harshith998/ORCA-Optical-Replication-Control-Apparatus/software/chamber-pi/src/io_controller.py

import RPi.GPIO as GPIO
from rpi_hardware_pwm import HardwarePWM

from config import (
    SWITCH1_PIN, SWITCH2_PIN, SWITCH3_PIN, PWM_PIN,
    LORA_SPI_PORT, LORA_SPI_DEVICE, LORA_NRESET_PIN, LORA_BUSY_PIN, LORA_DIO1_PIN,
    LORA_FREQ_MHZ, LORA_BW_KHZ, LORA_SF, LORA_CR, LORA_SYNC_WORD,
    PWM_FREQ, MAX_PWM_VALUE,
    LED_GRN_PIN, LED_YLW_PIN,
    ROTARY_A_PIN, ROTARY_B_PIN, ROTARY_BTN_PIN,
)
from lora_receiver import LoRaReceiver, decode_packet, PACKET_SIZE
from rotary_encoder import RotaryEncoder
from rs_receiver import RS485Receiver


class IOController:
    def __init__(self):
        # State variables
        self.sw1 = True
        self.sw2 = True
        self.sw3 = True
        self.lux_value = 0

        # Hardware handles
        self.lora = None
        self._pwm = None  # rpi-hardware-pwm instance for BCM 12 (PWM0)
        self.rs = RS485Receiver()
        self.rotary = RotaryEncoder(ROTARY_A_PIN, ROTARY_B_PIN, ROTARY_BTN_PIN)

        # YLW LED flash counter: set to N on packet receipt, decremented each update
        self._ylw_flash_ticks = 0

        # Set to True when a new packet is decoded; cleared by consume_new_packet()
        self._new_packet = False

        # Last decoded LoRa packet (full spectral + GPS data)
        self.last_packet = None

        # All 13 spectral channels from the last packet (keyed by channel name)
        self.spectral_channels = {}

        # Last GPS fix from the last packet
        self.last_gps = {'valid': False, 'latitude': 0.0, 'longitude': 0.0, 'unix_time': 0}

        # Init / diagnostics
        self.status = {
            'gpio': 'Not initialized',
            'pwm': 'Not initialized',
            'lora': 'Not initialized',
            'rs485': 'Not initialized',
            'leds': 'Not initialized',
            'rotary': 'Not initialized',
        }
        self.hardware_ready = {
            'gpio': False,
            'pwm': False,
            'lora': False,
        }

    def begin(self):
        """Initialize all hardware peripherals without crashing if optional hardware is absent."""
        # GPIO setup
        try:
            GPIO.setmode(GPIO.BCM)
            GPIO.setwarnings(False)
            GPIO.setup(SWITCH1_PIN, GPIO.IN, pull_up_down=GPIO.PUD_UP)
            GPIO.setup(SWITCH2_PIN, GPIO.IN, pull_up_down=GPIO.PUD_UP)
            GPIO.setup(SWITCH3_PIN, GPIO.IN, pull_up_down=GPIO.PUD_UP)
            self.status['gpio'] = (
                f"OK - GPIO ready (S1=BCM{SWITCH1_PIN}, S2=BCM{SWITCH2_PIN}, S3=BCM{SWITCH3_PIN}, PWM=BCM{PWM_PIN})"
            )
            self.hardware_ready['gpio'] = True
        except Exception as exc:
            self.status['gpio'] = f"Unavailable - GPIO init failed: {exc}"

        # Hardware PWM via Linux sysfs (rpi-hardware-pwm) — runs in the PWM peripheral,
        # independent of Python. Requires dtoverlay=pwm,pin=12,func=4 in config.txt.
        try:
            self._pwm = HardwarePWM(pwm_channel=0, hz=PWM_FREQ, chip=0)
            self._pwm.start(0)
            self.status['pwm'] = f"OK - hardware PWM on BCM{PWM_PIN} at {PWM_FREQ} Hz (sysfs)"
            self.hardware_ready['pwm'] = True
        except Exception as exc:
            self._pwm = None
            self.status['pwm'] = (
                f"Unavailable - hardware PWM init failed: {exc}. "
                f"Ensure dtoverlay=pwm,pin=12,func=4 is in config.txt and Pi has been rebooted."
            )

        # Indicator LED setup (GRN = wired connected, YLW = RS-485 activity)
        if self.hardware_ready['gpio']:
            try:
                GPIO.setup(LED_GRN_PIN, GPIO.OUT, initial=GPIO.LOW)
                GPIO.setup(LED_YLW_PIN, GPIO.OUT, initial=GPIO.LOW)
                self.status['leds'] = (
                    f'OK - GRN=BCM{LED_GRN_PIN} (wired link), YLW=BCM{LED_YLW_PIN} (RS-485 activity)'
                )
            except Exception as exc:
                self.status['leds'] = f'Unavailable - LED init failed: {exc}'
        else:
            self.status['leds'] = 'Skipped - GPIO not available'

        # Rotary encoder setup (interrupt-driven, requires GPIO ready)
        if self.hardware_ready['gpio']:
            self.rotary.begin()
            self.status['rotary'] = self.rotary.status
        else:
            self.status['rotary'] = 'Skipped - GPIO not available'

        # RS-485 / wired UART setup (SNS sense pin + /dev/serial0)
        self.rs.begin()
        self.status['rs485'] = self.rs.status

        # LoRa setup (SX1262 on spidev0.1 / CE1)
        try:
            self.lora = LoRaReceiver(
                spi_port=LORA_SPI_PORT,
                spi_device=LORA_SPI_DEVICE,
                reset_pin=LORA_NRESET_PIN,
                busy_pin=LORA_BUSY_PIN,
                dio1_pin=LORA_DIO1_PIN,
            )
            self.lora.begin(
                freq_mhz=LORA_FREQ_MHZ,
                bw_khz=LORA_BW_KHZ,
                sf=LORA_SF,
                cr=LORA_CR,
                sync_word=LORA_SYNC_WORD,
            )
            self.status['lora'] = (
                f"OK - SX1262 receiving at {LORA_FREQ_MHZ} MHz "
                f"BW{LORA_BW_KHZ} SF{LORA_SF} CR4/{LORA_CR} sync=0x{LORA_SYNC_WORD:02X}"
            )
            self.hardware_ready['lora'] = True
        except Exception as exc:
            self.lora = None
            self.status['lora'] = f"Unavailable - LoRa init failed: {exc}"

    def update(self):
        """Update all input states."""
        self._read_switches()

        # Prefer wired RS-485 when a cable is detected, mirroring the firmware
        # path: is_connected() → rs485_send, else → LoRa.
        wired = self.rs.is_connected()
        if wired:
            self._read_rs485()
        else:
            self._read_lora()

        self._update_leds()

    def _update_leds(self):
        """Drive indicator LEDs based on connection and activity state."""
        if not self.hardware_ready.get('gpio'):
            return
        try:
            # GRN: solid on when RJ45 cable is plugged in
            GPIO.output(LED_GRN_PIN, GPIO.HIGH if self.rs.is_connected() else GPIO.LOW)

            # YLW: flashes for ~500 ms after each RS-485 packet is received
            if self._ylw_flash_ticks > 0:
                self._ylw_flash_ticks -= 1
                GPIO.output(LED_YLW_PIN, GPIO.HIGH)
            else:
                GPIO.output(LED_YLW_PIN, GPIO.LOW)
        except Exception as exc:
            print(f'[LED] Output error: {exc}')

    def _read_switches(self):
        """Read switch states (pull-up: HIGH = released)."""
        if not self.hardware_ready['gpio']:
            self.sw1 = True
            self.sw2 = True
            return
        self.sw1 = GPIO.input(SWITCH1_PIN)
        self.sw2 = GPIO.input(SWITCH2_PIN)
        self.sw3 = GPIO.input(SWITCH3_PIN)

    def _read_lora(self):
        """Poll SX1262 for a received packet and decode it."""
        if not self.hardware_ready['lora'] or self.lora is None:
            return
        try:
            raw = self.lora.poll()
            if raw is None:
                return
            if raw == b'':
                print("[LoRa] CRC error — packet discarded")
                return
            print(f"[LoRa] Packet received: {len(raw)} bytes | hex: {raw.hex()}")
            packet = decode_packet(raw)
            if packet is None:
                print(f"[LoRa] Decode failed: got {len(raw)} bytes, expected {PACKET_SIZE}")
                return
            self.last_packet = packet
            self.spectral_channels = packet['channels']
            self.lux_value = packet['channels']['clear']
            self.last_gps = packet['gps']
            self._new_packet = True
            print(f"[LoRa] Decoded: sample={packet['sample_count']} clear={packet['channels']['clear']} gps_valid={packet['gps']['valid']}")
        except Exception as exc:
            print(f"[LoRa] Exception in _read_lora: {exc}")

    def _read_rs485(self):
        """Poll the RS-485 UART for a complete packet and decode it."""
        packet = self.rs.poll()
        if packet is None:
            return
        print(f'[RS485] Packet received: sample={packet["sample_count"]} '
              f'clear={packet["channels"]["clear"]} gps_valid={packet["gps"]["valid"]}')
        self.last_packet = packet
        self.spectral_channels = packet['channels']
        self.lux_value = packet['channels']['clear']
        self.last_gps = packet['gps']
        self._new_packet = True
        # Trigger YLW flash for ~500 ms (5 ticks at 100 ms loop rate)
        self._ylw_flash_ticks = 5

    def is_wired_connected(self) -> bool:
        """Return True when a cable is detected on the RJ45 sense pin."""
        return self.rs.is_connected()

    def set_pwm(self, value):
        """Set PWM duty cycle (0-1023 maps to 0-100%).

        Delegates to hardware PWM peripheral via sysfs — continues at this
        duty cycle even if the Python process hangs between calls.
        """
        if not self.hardware_ready['pwm'] or self._pwm is None:
            return
        duty = (value / MAX_PWM_VALUE) * 100.0
        duty = max(0.0, min(100.0, duty))
        self._pwm.change_duty_cycle(duty)

    def get_switch1(self):
        return self.sw1

    def get_switch2(self):
        return self.sw2

    def get_switch3(self):
        return self.sw3

    def get_lux_value(self):
        return self.lux_value

    def get_spectral_channels(self) -> dict:
        return dict(self.spectral_channels)

    def get_last_gps(self) -> dict:
        return dict(self.last_gps)

    def consume_new_packet(self) -> bool:
        """Returns True (and clears the flag) if a new packet was decoded this tick."""
        if self._new_packet:
            self._new_packet = False
            return True
        return False

    def get_rotary_position(self) -> int:
        return self.rotary.get_position()

    def consume_rotary_click(self) -> bool:
        return self.rotary.consume_click()

    def get_init_report(self):
        return dict(self.status)

    def to_string(self):
        """Return string representation for debugging."""
        sw1_str = "HIGH" if self.sw1 else "LOW "
        sw2_str = "HIGH" if self.sw2 else "LOW "
        return (f"[Switches] S1={sw1_str} S2={sw2_str} | "
                f"[Lux] {self.lux_value}")

    def cleanup(self):
        """Cleanup GPIO and peripherals."""
        if self._pwm is not None:
            try:
                self._pwm.stop()
            except Exception:
                pass
        if self.lora:
            try:
                self.lora.close()
            except Exception:
                pass
        try:
            self.rs.close()
        except Exception:
            pass
        try:
            self.rotary.cleanup()
        except Exception:
            pass
        try:
            GPIO.cleanup()
        except Exception:
            pass
