harshith998/ORCA-Optical-Replication-Control-Apparatus/firmware/module-esp32/src/main.cpp

#include <Wire.h>
#include "Adafruit_VEML7700.h"

// VEML7700 I2C Sensor Pins
#define SDA1 21
#define SCL1 22
#define SDA2 33
#define SCL2 32

// UART RS-485 Constants
#define SAMPLE_MS = 20
#define UART0_BAUD = 115200

// VEML7700 Setup
Adafruit_VEML7700 veml1 = Adafruit_VEML7700();
Adafruit_VEML7700 veml2 = Adafruit_VEML7700();
TwoWire I2C_1 = TwoWire(0);
TwoWire I2C_2 = TwoWire(1);
unsigned long lastSample = 0;

void setup() {
  Serial.begin(UART0_BAUD);
  
  // Initialize sensors
  I2C_1.begin(SDA1, SCL1);
  if (!veml1.begin(&I2C_1)) {
    Serial.println("ERROR: Failed to initialize VEML7700-1");
    ESP.restart(); // Attempt to restart ESP32
  }
  veml1.setGain(VEML7700_GAIN_1);
  veml1.setIntegrationTime(VEML7700_IT_100MS);
  
  I2C_2.begin(SDA2, SCL2);
  if (!veml2.begin(&I2C_2)) {
    Serial.println("ERROR: Failed to initialize VEML7700-2");
    ESP.restart(); // Attempt to restart ESP32
  }
  veml2.setGain(VEML7700_GAIN_1);
  veml2.setIntegrationTime(VEML7700_IT_100MS);
  
  delay(1000);  // Give receiver time to start
  lastSample = millis();
}

void loop() {
  // Transmit data every SAMPLE_MS milliseconds
  unsigned long now = millis();
  if (now - lastSample >= SAMPLE_MS) {
    lastSample = now;
    
    // Read both sensors and send averaged lux intensity via UART
    float lux1 = veml1.readLux();
    float lux2 = veml2.readLux();
    Serial.println((lux1 + lux2)/2.0, 2);
  }
}
