harshith998/ORCA-Optical-Replication-Control-Apparatus/firmware/chamber-esp32/test/test.cpp

#include <Arduino.h>
#include <Wire.h>

// ---------- Pin Definitions ----------
#define SWITCH1_PIN 14      // Input switch 1 with pull-up
#define SWITCH2_PIN 12       // Input switch 2 with pull-up
#define SWITCH3_PIN 27       // Potentiometer pin (measure voltage 3.3V)
#define PWM_PIN     25      // PWM output pin (GPIO25)
#define LCD_SDA     21      // LCD SDA Pin
#define LCD_SCL     22      // LCD SCL Pin
#define UART0_BAUD  115200  // UART0 baud rate

// ---------- PWM Settings ----------
#define PWM_FREQ     5000   // 5 kHz PWM
#define PWM_CHANNEL  0      // Default PWM Channel
#define PWM_RES_BITS 10     // 10-bit (0–1023)
#define MAX_PWM_VALUE 1023  // Max value for 10-bit

void setup() {
  Serial.begin(UART0_BAUD);           // UART0 (GPIO3 RX, GPIO1 TX)
  pinMode(SWITCH1_PIN, INPUT_PULLUP); // Switch 1
  pinMode(SWITCH2_PIN, INPUT_PULLUP); // Switch 2
  pinMode(SWITCH3_PIN, INPUT);        // Potentiometer voltage measuring
  pinMode(PWM_PIN, OUTPUT);           // Output PWM signal for controlling LEDs
  Wire.begin(LCD_SDA, LCD_SCL);
  Wire.setClock(400000); // 400 kHz (use 100000 for standard mode if needed)

  // Configure PWM
  ledcSetup(PWM_CHANNEL, PWM_FREQ, PWM_RES_BITS);
  ledcAttachPin(PWM_PIN, PWM_CHANNEL);

  Serial.println("ESP32 PWM control ready");
}

void loop() {
  // -------- Read UART0 RX3 line --------
  if (Serial.available()) {
    String line = Serial.readStringUntil('\n');
    line.trim();

    // Example incoming line: "252953,79.03,165.43"
    // Split by commas
    int firstComma = line.indexOf(',');
    int secondComma = line.indexOf(',', firstComma + 1);

    if (firstComma != -1 && secondComma != -1) {
      String val1Str = line.substring(firstComma + 1, secondComma);
      String val2Str = line.substring(secondComma + 1);
      float val1 = val1Str.toFloat();
      float val2 = val2Str.toFloat();

      float avg = (val1 + val2) / 2.0;

      // Scale and cap
      float dutyValue = avg;               // scale directly (0–10 000 range)
      if (dutyValue > 3500) dutyValue = 3500;

      // Convert to PWM range
      int pwmOut = map((int)dutyValue, 0, 3500, 0, MAX_PWM_VALUE);

      // -------- Switch control --------
      if (digitalRead(SWITCH1_PIN) == HIGH) {
        ledcWrite(PWM_CHANNEL, pwmOut);
      } else {
        ledcWrite(PWM_CHANNEL, 0);  // Force output LOW
      }

      // Debug print
      Serial.print("Input avg: ");
      Serial.print(avg, 2);
      Serial.print("  -> PWM duty: ");
      Serial.println(pwmOut);
    }
  }
}
