harshith998/ORCA-Optical-Replication-Control-Apparatus/(commit log)

2025-10-31 Update from old repo
    has all information from deprecitated repository
    [EGR 101-B_Cu.gbr, EGR 101-B_Mask.gbr, EGR 101-B_Paste.gbr, EGR 101-B_Silkscreen.gbr, EGR 101-Edge_Cuts.gbr, EGR 101-F_Cu.gbr, EGR 101-F_Mask.gbr, EGR 101-F_Paste.gbr]
2025-10-31 update reciever
    update reciever py code for Serial over Ethernet capabilities,, and pure PWM based LED projection instead of digital output.
2025-10-31 test for SerialOverEthernet
    This was code for simple test with hardware (successful) to validate chips and wiring schematic to send data over ethernet as serial byte-stream data.
2025-10-31 update sensor module
    Update sensor module logic to accomodate for Serial over Ethernet byte-stream transmission
2025-11-04 Fixed ESP32 code. Transmits CSV UART every 500 ms over 115200
    [1LED.cpp, Ethernet_connection.cpp, I2C_Switching.cpp, LCD_test1.cpp, esp32module.cpp, main.cpp, recieve.py]
2025-11-04 Pico ADC code finished. Baud set 115200 over TX. Read analog pin 26
2025-11-05 updated changes for LCD and switches analog control
2025-11-12 refactor for easy switching B/W reciever
2025-11-13 Test ESP32 Chamber
2025-11-14 REORGANIZED EVERYTHING
    [EGR 101-B_Cu.gbr, EGR 101-B_Mask.gbr, EGR 101-B_Paste.gbr, EGR 101-B_Silkscreen.gbr, EGR 101-Edge_Cuts.gbr, EGR 101-F_Cu.gbr, EGR 101-F_Mask.gbr, EGR 101-F_Paste.gbr]
2026-01-31 Started Satellite board. Next steps: fix power switch between solar and RJ45 on MPPT
    [satellite-board.kicad_pcb, satellite-board.kicad_sch]
2026-01-31 wait more changes
    [satellite-board.kicad_sch]
2026-02-01 GPS Module | Updated schematic
    Added GPS module. Need to apply load switch via PHET circuit. Also need to wire I2C for light sensor breakout (also on load switch). Need to design both antenna hookups. GL
2026-02-01 New GPS module
    [satellite-board.kicad_sch]
2026-02-01 Everything added to satelite schematic,
    Need to finish wiring MCU
    [satellite-board.kicad_sch]
2026-02-02 Satelite Schematic Finished
    [satellite-board.kicad_sch]
2026-02-04 Started work on primary board
    [central-board.kicad_pcb, central-board.kicad_sch]
2026-02-04 Updates to buck, review TI
    [central-board.kicad_sch]
2026-02-05 updates to central
    [central-board.kicad_sch, satellite-board.kicad_sch]
2026-02-05 Satelite & Central Schematic Finished
    [central-board.kicad_sch, satellite-board.kicad_sch]
2026-02-05 LCSC for Sat.
    [satellite-board.kicad_sch]
2026-02-06 LCSC Updates
    [central-board.kicad_pcb, central-board.kicad_sch, satellite-board.csv, satellite-board.kicad_pcb]
2026-02-07 Primary Board PCB Updates
    2 bucks finished
    [central-board.kicad_pcb, central-board.kicad_sch]
2026-02-08 updates to primary
    [central-board.kicad_pcb]
2026-02-08 more updates
    [central-board.kicad_pcb, central-board.kicad_sch]
2026-02-08 All primary components mounted
    [central-board.kicad_pcb, central-board.kicad_sch]
2026-02-09 Updates to Fill
    [central-board.kicad_pcb]
2026-02-09 No more errors!
    [central-board.kicad_pcb]
2026-02-10 Primary prepared for order
    [central-board-B_Cu.gbr, central-board-B_Mask.gbr, central-board-B_Paste.gbr, central-board-B_Silkscreen.gbr, central-board-Edge_Cuts.gbr, central-board-F_Cu.gbr, central-board-F_Mask.gbr, central-board-F_Paste.gbr]
2026-02-13 Layout started
    [satellite-board.kicad_pcb]
2026-02-13 Satelite Board Started
    [satellite-board.kicad_pcb, satellite-board.kicad_sch]
2026-02-13 Updates to Sat
    [satellite-board.kicad_pcb, satellite-board.kicad_sch]
2026-02-15 Branch updates
    [satellite-board-B_Cu.gbr, satellite-board-B_Mask.gbr, satellite-board-B_Paste.gbr, satellite-board-B_Silkscreen.gbr, satellite-board-Edge_Cuts.gbr, satellite-board-F_Cu.gbr, satellite-board-F_Mask.gbr, satellite-board-F_Paste.gbr]
2026-02-16 Prepared for production
    [central-board-B_Cu.gbr, central-board-B_Mask.gbr, central-board-B_Paste.gbr, central-board-B_Silkscreen.gbr, central-board-Edge_Cuts.gbr, central-board-F_Cu.gbr, central-board-F_Mask.gbr, central-board-F_Paste.gbr]
2026-04-06 MAY OR MAY NOT WORK
    [config.py, web_server.py]
2026-04-06 Fixed some stuff hopefully
    [config.py, io_controller.py, lcd_display.py, main.py]
2026-04-08 flipped pwm
2026-04-09 Claude updates to fix LORA
    [io_controller.py, lora_receiver.py, satellite-firmware.cpp]
2026-04-09 If this doesn't work I give up
    [lora.py]
2026-04-09 print status added
2026-04-09 packets are starting to flow!
2026-04-09 new print statements
2026-04-09 ANALOG READ BROKE EVERYTHING
    [config.py, io_controller.py, main.py, web_server.py]
2026-04-09 Claude got rid of my SPI bus
2026-04-12 To Test
    [central-board.kicad_sch]
2026-04-12 UART test
2026-04-12 Claude claims will fix or smth.
    [io_controller.py, rs_receiver.py]
2026-04-13 UART doesn't work
2026-04-13 Uart fixes (in theory)
    [main.py]
2026-04-13 Claude claims critical issues
    [main.py, solar_check.py]
2026-04-13 Lower frequency, possibly need to switch from RPi.GPIO to pigpio
2026-04-13 "Fixes" that should reduce overhead that is resulting in poor peformance
    [io_controller.py, main.py, solar_check.py, usb_logger.py]
2026-04-13 Switched to pigpio
2026-05-09 Fixed redundant print, added all solenoid pins
    [config.py, io_controller.py, main.py, web_server.py]
2026-05-09 Fixed startup sequence and print statements during main loop
    [config.py, io_controller.py, lcd_display.py, lora_receiver.py, main.py, web_server.py]
2026-05-09 IMPORTANT: REMOVED CLAMPING & ADDED SQL WIPE
2026-05-09 Download button and data-delete update
2026-05-09 Fixed units for solar irradiance on cosine calculation
    [solar_check.py]
2026-05-11 Disabled RS_EN to fix RS-485 transmit
    [rs_transciever.c, satellite-firmware.cpp]
2026-05-11 Line fix top left of UI
    [web_server.py]
2026-05-11 Revert "Line fix top left of UI"
    This reverts commit f89d702fa051f0b52a3760fc6986feb85c00b999.
    [web_server.py]
2026-05-11 Revert "Maybe fix?"
    This reverts commit 21ac8ed1302533689467bd9a6a4f324cd5ec175d.
    [web_server.py]
2026-05-11 Revert "GPS clock"
    This reverts commit f8b2190e1d4363d82ec303188a9c0fd2d026177d.
    [web_server.py]
2026-05-11 Maybe fix UTC clock issue
    [web_server.py]
2026-05-12 Revert "100% fix error?"
    This reverts commit 41c983a6956bf966ba57bb0d1dd02759eddb7a0f.
    [main.py]
2026-05-12 README attached
