harshith998/ORCA-Optical-Replication-Control-Apparatus/(notices)

Notices in the files:
README.md:
License: MIT
